SzymonDobrowolski/pulse_generator_for_lpg_injectors/lt_spice/pulse_generator.asc

C1: cap; {C_range}
C2: cap; 0.1µ
C3: polcap; 2200µ; V=25
C4: cap; 0.1µ
C5: cap; 0.1µ
C6: polcap; 10µ; V=25
D1: schottky; MBR735
D2: diode; 1N4148
D3: diode; 1N4148
D4: schottky; MBR735
D5: schottky; MBR735
D6: schottky; MBR735
L1: ind; 5m
L2: ind; 5m
L3: ind; 5m
L4: ind; 5m
M1: nmos; IRFZ44N
R1: res; 1k
R2: res; {PotTotal * (1 - Wiper + 0.001)}
R3: res; {PotTotal * (Wiper + 0.001)}
R4: res; 100
R5: res; 10k
R6: res; 3
R7: res; 3
R8: res; 3
R9: res; 3
R10: res; 100k
R11: res; 10K
U1: NE555
U2: NE555
V1: voltage; 12
V2: voltage; PULSE(12 0 0.1 1m 1m 0.1 100)
Named nets: 0
.tran 5
LPG INJECTORS
.param Wiper = 0.5
.param PotTotal = 100k
1
2
3
4
1) Time of simulation [s]:
Simulation paramaters (right click on black text to change values)
2) Default potentiometer resistance:
3) Changing of potentiometer's resistance (wiper) [%]:
SLAVE
4) Changing of capacitor's capacitance (frequency):
.step param C_range list 10u 0.47u 0.22u
Power supply
Button on / off
MASTER
5) For the test the working time is set as 1 second (C6 and R10 are responsible for time T = 1.1 * R * C)
