SzymonDobrowolski/pulse_generator_for_lpg_injectors/(list of files, drawings)

Other design files:
pcb_project/pulse_generator/pulse_generator.PcbDoc
pcb_project/pulse_generator/pulse_generator.PrjPcb
pcb_project/pulse_generator/pulse_generator.SchDoc
