SzymonDobrowolski/pulse_generator_for_lpg_injectors/(commit log)

2026-01-18 Update readme
    Updated project description and added sections for concept, analysis, PCB, and testing.
2026-01-19 final schematic + pcb
    [pulse_generator.PcbDoc, pulse_generator.PrjPcb, pulse_generator.SchDoc]
2026-01-19 gerber files added, waiting for order
    [pulse_generator.GBL, pulse_generator.GBP, pulse_generator.GBS, pulse_generator.GM1, pulse_generator.GTL, pulse_generator.GTO, pulse_generator.GTP, pulse_generator.GTS]
2026-01-19 added 3D model of Q1
    [pulse_generator.GBL, pulse_generator.GBP, pulse_generator.GBS, pulse_generator.GM1, pulse_generator.GTL, pulse_generator.GTO, pulse_generator.GTP, pulse_generator.GTS]
2026-01-19 new gerber files
2026-01-20 PCB size optimalization
    [pulse_generator.GBL, pulse_generator.GBP, pulse_generator.GBS, pulse_generator.GM1, pulse_generator.GTL, pulse_generator.GTO, pulse_generator.GTP, pulse_generator.GTS]
2026-01-20 Update MOSFET references in README.md
2026-01-27 small changes / not importnat
    [pulse_generator.PcbDoc, pulse_generator.PrjPcb]
2026-02-03 little changes
    [pulse_generator.GBL, pulse_generator.GBP, pulse_generator.GBS, pulse_generator.GM1, pulse_generator.GTL, pulse_generator.GTO, pulse_generator.GTP, pulse_generator.GTS]
2026-03-11 Update README to simplify bottom layout description
    Removed specific details about exposed copper traces in the bottom layout section.
2026-03-14 Update README for clarity on PWM knob adjustment
2026-03-14 Revise usage guide and safety instructions in README
    Updated the usage guide and safety guidelines for low-resistance injectors, including detailed steps for initial setup, frequency modes, and cleaning maintenance.
2026-09-01 new photos after test added
    [pulse_generator.SchDoc]
